bobsomers/iDo/hardware/projects/ido/ido.brd

## EAGLE design hardware/projects/ido/ido.brd (2017-03-30)

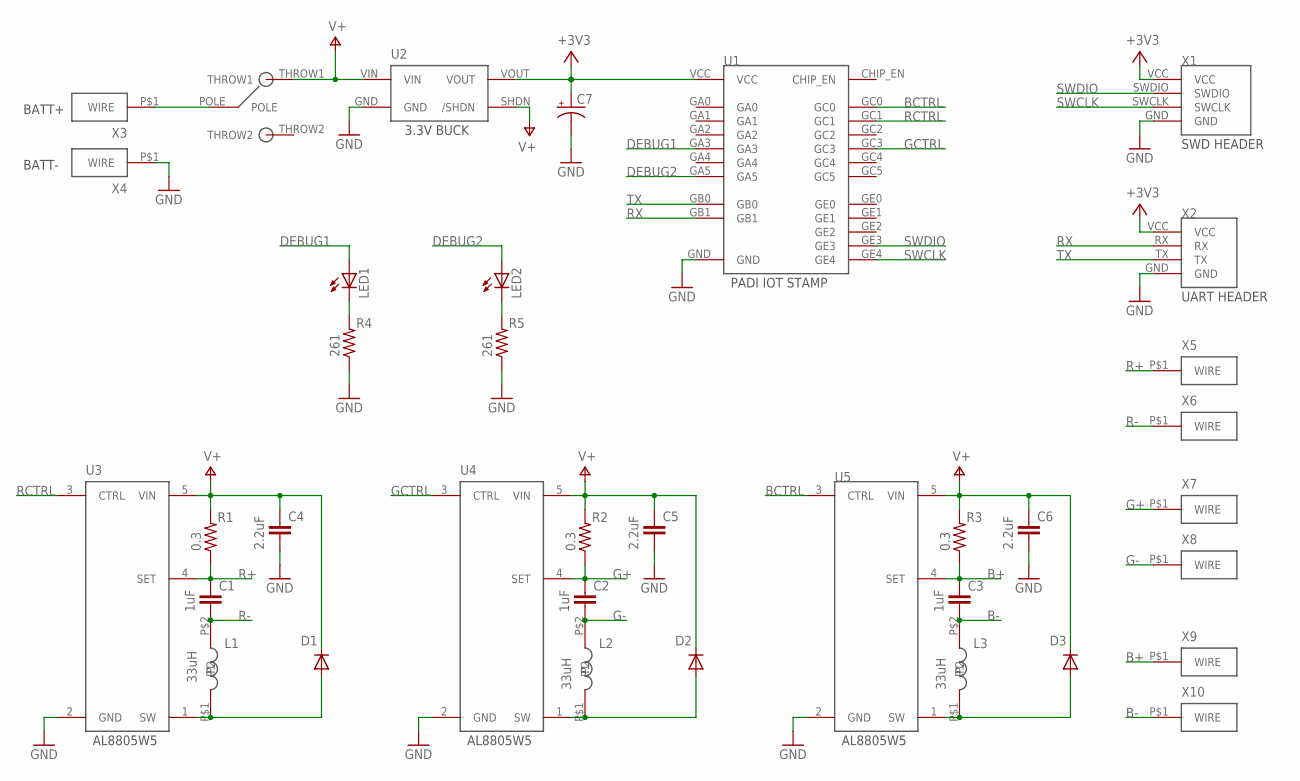
[picture p1: schematic ido.sch]

Parts:
C1, C2, C3: 1uF; C0603
C4, C5, C6: 2.2uF; C0603
C7: CPOL-USE2.5-7; E2,5-7
D1, D2, D3: DIODE-DO214AC; DO214AC
L1, L2, L3: 33uH; MURATA-INDUCTOR
LED1, LED2: LEDCHIPLED_0603; CHIPLED_0603
R1, R2, R3: 0.3; R0603
R4, R5: 261; R0603
S1: SLIDE-SWITCH
U1: PADI-IOT-STAMP
U2: POLOLU-BUCK
U3, U4, U5: AL8805W5; SOT25
X1: PROGRAMMING-HEADER
X2: UART-HEADER
X3, X4, X5, X6, X7, X8, X9, X10: WIRE-HOLE

Connections:
+3V3: C7.+, U1.VCC, U2.VOUT, X1.VCC, X2.VCC
B+: C3.1, R3.1, U5.4 (SET), X9.P$1
B-: C3.2, L3.P$2 (P2), X10.P$1
BCTRL: U1.GC0, U5.3 (CTRL)
DEBUG1: LED1.A, U1.GA3
DEBUG2: LED2.A, U1.GA5
G+: C2.1, R2.1, U4.4 (SET), X7.P$1
G-: C2.2, L2.P$2 (P2), X8.P$1
GCTRL: U1.GC3, U4.3 (CTRL)
GND: C4.2, C5.2, C6.2, C7.-, R4.1, R5.1, U1.GND, U2.GND, U3.2 (GND), U4.2 (GND), U5.2 (GND), X1.GND, X2.GND, X4.P$1
unnamed: S1.POLE, X3.P$1
unnamed: LED2.C, R5.2
unnamed: D1.A, L1.P$1 (P1), U3.1 (SW)
unnamed: LED1.C, R4.2
unnamed: D2.A, L2.P$1 (P1), U4.1 (SW)
unnamed: D3.A, L3.P$1 (P1), U5.1 (SW)
R+: C1.1, R1.1, U3.4 (SET), X5.P$1
R-: C1.2, L1.P$2 (P2), X6.P$1
RCTRL: U1.GC1, U3.3 (CTRL)
RX: U1.GB1, X2.RX
SWCLK: U1.GE4, X1.SWCLK
SWDIO: U1.GE3, X1.SWDIO
TX: U1.GB0, X2.TX
V+: C4.1, C5.1, C6.1, D1.C, D2.C, D3.C, R1.2, R2.2, R3.2, S1.THROW1, U2.SHDN (/SHDN), U2.VIN, U3.5 (VIN), U4.5 (VIN), U5.5 (VIN)

Notes on the sheet:
BATT+
BATT-

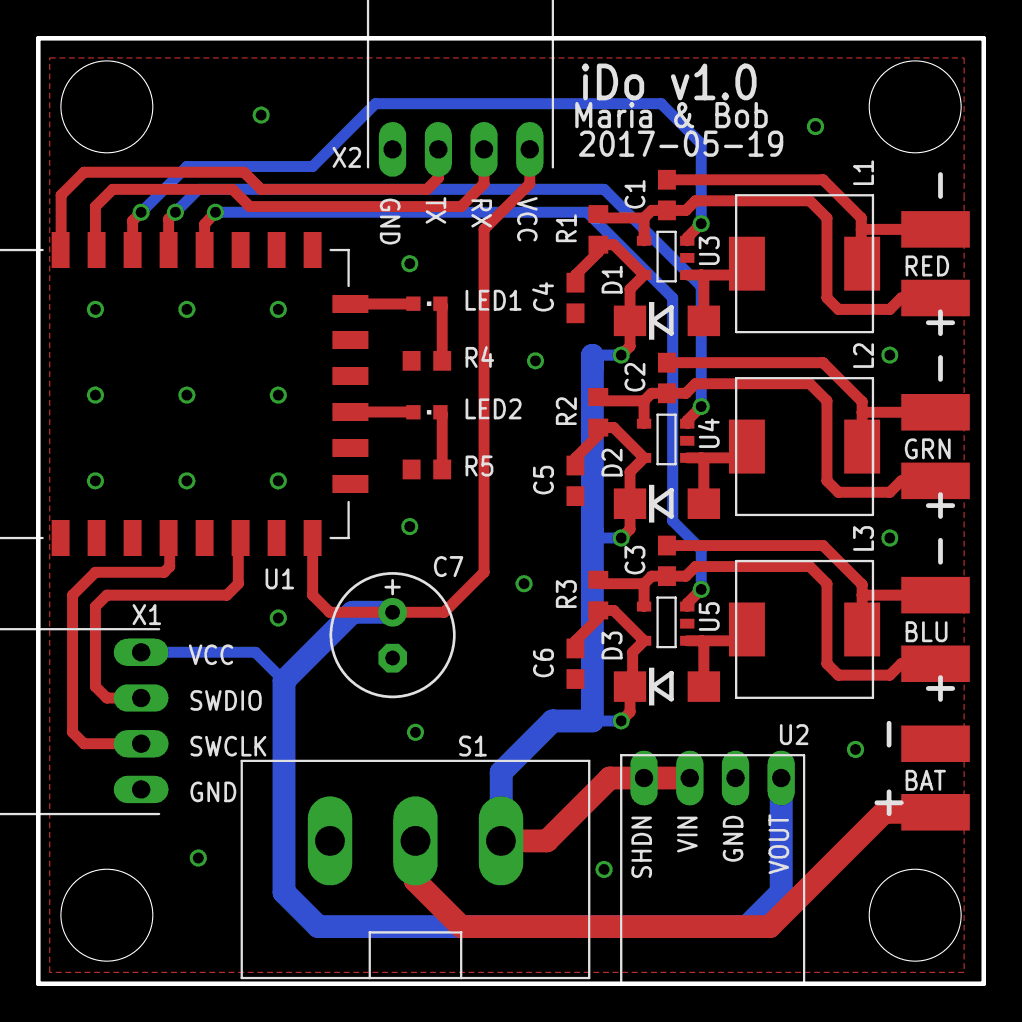
[picture p2: board ido.brd from above]

Board: 2 copper layers, 52.5 x 52.5 mm, 36 parts (0 on the bottom side), 24 nets.
