bobsomers/iDo/software/showtime/audio_effect.cpp

#include "audio_effect.h"

#include <iostream>
#include <numeric>

#include "showtime/audio_device.h"

namespace showtime {

ColorChannels AudioEffect::process(double t_seconds, void* /*data*/) {
  ColorChannels c;

  // Grab the latest spectrum data
  auto freq_out = AudioDevice::process();

  if (freq_out.size()) {
    // Grab the minimum and maximum values in the spectrum

    ColorGradient colorGradient;    // Used to create a nice array of different colors.
    colorGradient.createGradient1();

    // Stupid way to slice up each section of the spectrum. Cut it
    // into c.size() sections and find the mean for each and that's
    // your final magnitude
    int step = (freq_out.size() / c.size());
    for (unsigned int idx = 0; idx < c.size(); ++idx) {
      const unsigned int freq_idx = idx * step;

      // Accumulate and average the values
      float total = std::accumulate(freq_out.begin() + freq_idx, freq_out.begin() + freq_idx + step, 0);
      float average = total / (float)step;

      // Pass the average value to the gradient map. We're not doing any stretching of the average value
      // because we're lazy and we don't seem to need to. Might require some tweaking though.
      colorGradient.getColorAtValue(average, c[idx].r, c[idx].g, c[idx].b);
    }
  }

  return c;
}

} // namespace showtime
