bobsomers/iDo/software/showtime/color_fade_effect.cpp

#include "color_fade_effect.h"

#include <cstdlib>

#include "utils.h"

namespace showtime {

ColorFadeEffect::ColorFadeEffect(double delay) {
  for (int i = 0; i < 26; ++i) {
    c[i] = randomColor();
  }
  next_time_ = -1.0;
  delay_ = delay;
}

ColorChannels ColorFadeEffect::process(double t_seconds, void* /*data*/) {
  if (next_time_ < 0.0) {
    next_time_ = t_seconds + delay_;
    return c;
  }

  if (t_seconds > next_time_) {
    int which = std::rand() % 26;
    c[which] = randomColor();
    next_time_ = t_seconds + delay_;
  }

  return c;
}

} // namespace showtime
