bobsomers/iDo/firmware/padi/inc/build_info.h

#define UTS_VERSION "2017/05/14-23:41:28"
#define RTL8195AFW_COMPILE_TIME "2017/05/14-23:41:28"
#define RTL8195AFW_COMPILE_DATE "20170514"
#define RTL8195AFW_COMPILE_BY "bsomers"
#define RTL8195AFW_COMPILE_HOST ""
#define RTL8195AFW_COMPILE_DOMAIN ""
#define RTL195AFW_COMPILER "gcc 4.8.3"
