bobsomers/iDo/software/showtime/visualizer_sink.h

#pragma once

#include <nanogui/nanogui.h>

#include "showtime/sink.h"
#include "showtime/types.h"

namespace showtime {

class VisualizerSink : public Sink {
public:
  VisualizerSink();
  ~VisualizerSink() override;

  void sink(ColorChannels channels) override;

private:
  void makeTables();
  void makeLights();
  nanogui::GLShader table_shader_;
  nanogui::GLShader light_shader_;
};

} // namespace showtime
