bobsomers/iDo/software/showtime/effect.h

#pragma once

#include "showtime/types.h"

namespace showtime {

class Effect {
public:
  virtual ~Effect() {}
  // TODO: Replace void* data with audio data type.
  virtual ColorChannels process(double t_seconds, void* data) = 0;
};

} // namespace showtime
