bobsomers/iDo/software/showtime/all_off_effect.h

#pragma once

#include "showtime/effect.h"
#include "showtime/types.h"

namespace showtime {

class AllOffEffect final : public Effect {
public:
  ColorChannels process(double, void*) override;
};

} // namespace showtime
