bobsomers/iDo/(commit log)

2017-02-28 Playing around with RGB LEDs.
2017-03-14 PWM working.
2017-03-21 Add iDo schematic WIP.
    [ido.sch]
2017-03-23 Adding heatsink datasheet.
2017-03-23 Added debug LEDs.
    [ido.sch]
2017-03-23 Preliminary board placement.
    [ido.brd, ido.sch]
2017-03-24 Board and hole dimensions set and layout WIP.
    [ido.brd]
2017-03-28 Final board rev.
    [ido.brd, ido.sch]
2017-03-30 Move diodes down a bit to make assembly easier.
    [ido.brd]
2017-04-16 WIP firmware on production boards.
2017-05-14 Status LEDs task.
2017-05-15 Limit packet rate to 10 Hz.
2017-05-19 Added ring buffer for audio. Added fftw to build process. Tried (and failed) to add FFT calls... seems to be causing a segfault when uncommented
    [app.cpp, audio_device.cpp, audio_device.h]
2017-05-19 Fixed FFTW and had it output semi-sane sound spectrums
    [app.cpp, audio_device.cpp]
